CristianMSR/Oximetro/coso.jpeg

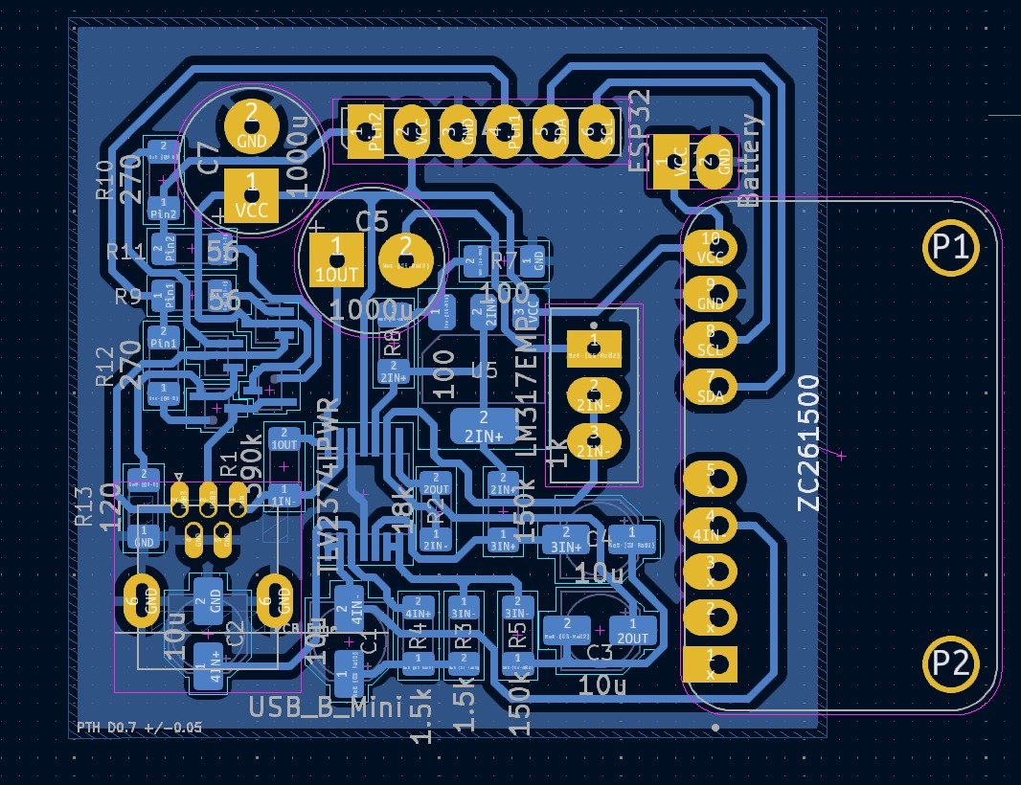
coso.jpeg
