CristianMSR/Oximetro/coso2.jpeg

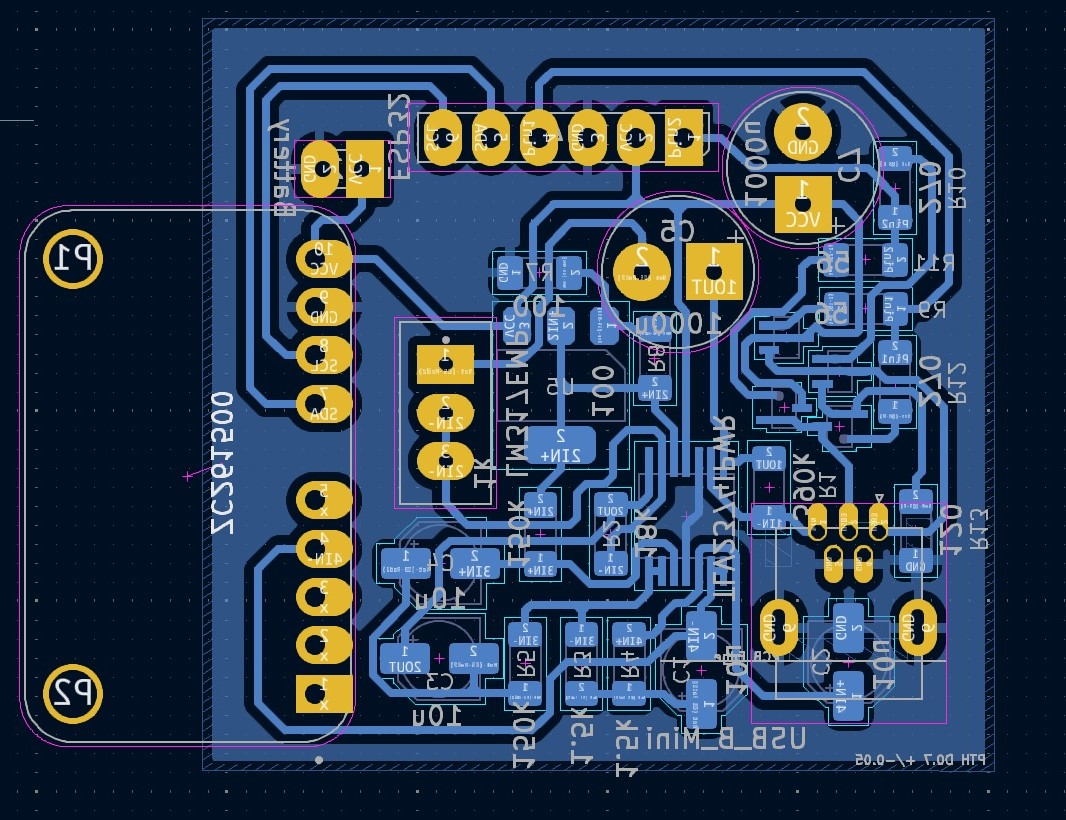
coso2.jpeg
