CristianMSR/Oximetro/capturas_osciloscopio/salidaAmplif.jpg

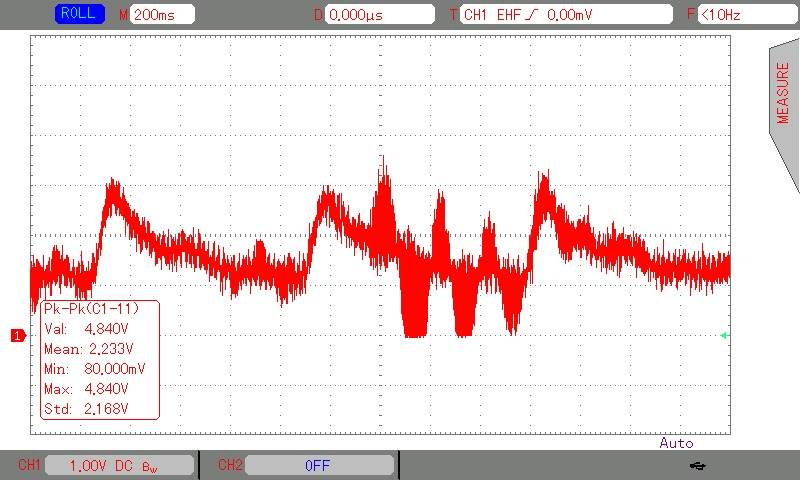
capturas_osciloscopio/salidaAmplif.jpg
