CristianMSR/Oximetro/capturas_osciloscopio/salidaFPA.jpg

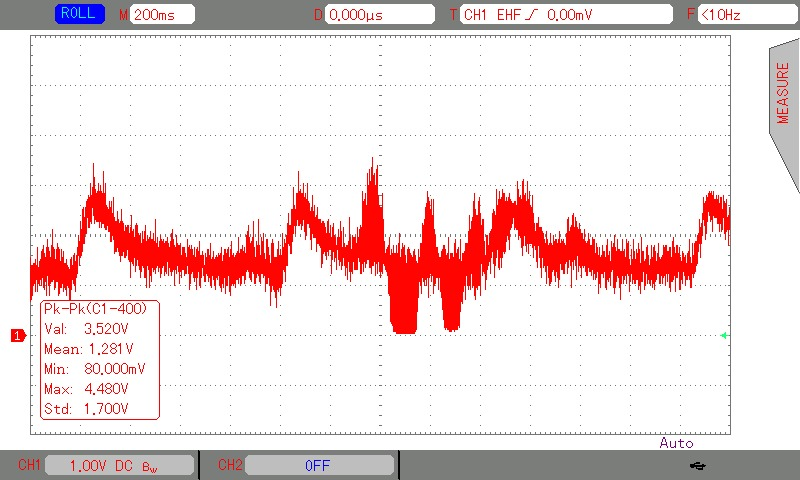
capturas_osciloscopio/salidaFPA.jpg
