CristianMSR/Oximetro/capturas_osciloscopio/salidaTransimp.jpg

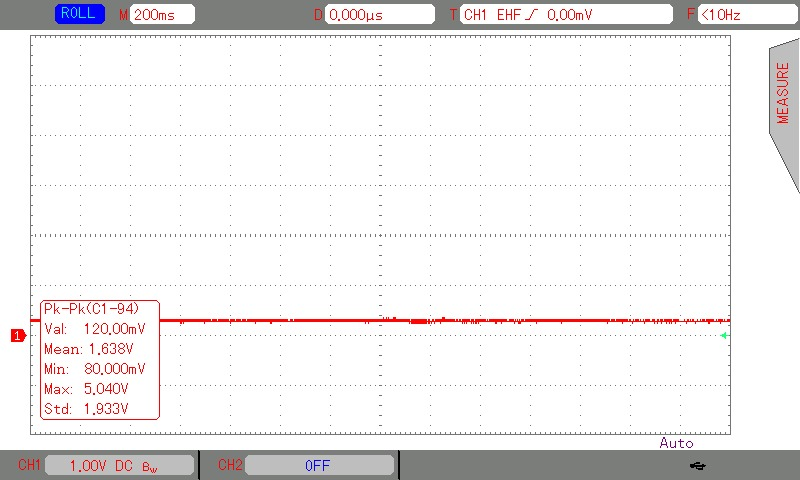
capturas_osciloscopio/salidaTransimp.jpg
