CristianMSR/Oximetro/capturas_osciloscopio/senalIR.jpg

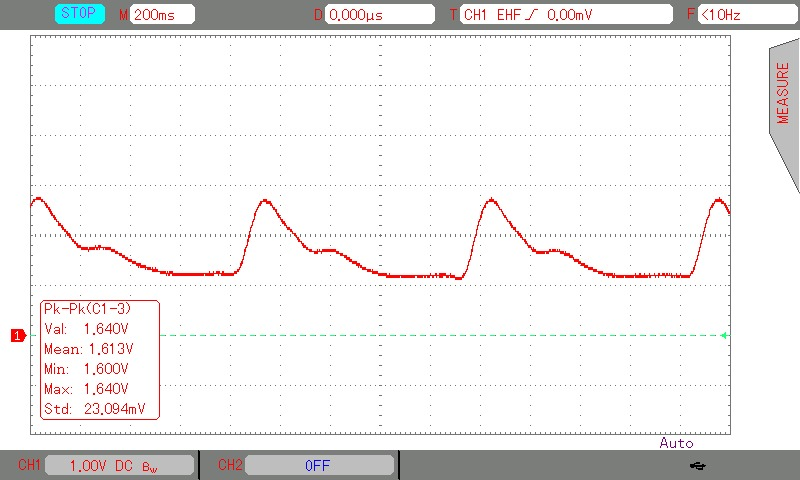
capturas_osciloscopio/senalIR.jpg
