CristianMSR/Oximetro/capturas_osciloscopio/senalRoja.jpg

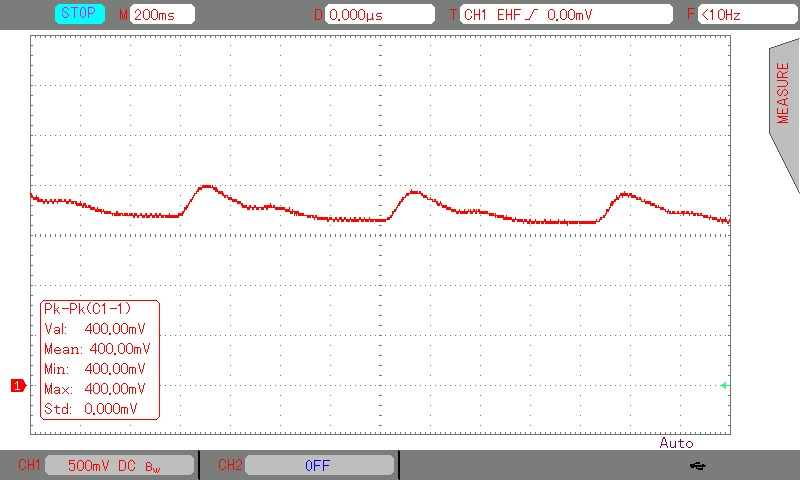
capturas_osciloscopio/senalRoja.jpg
