CristianMSR/Oximetro/Diagrama de bloques anteproyecto.png

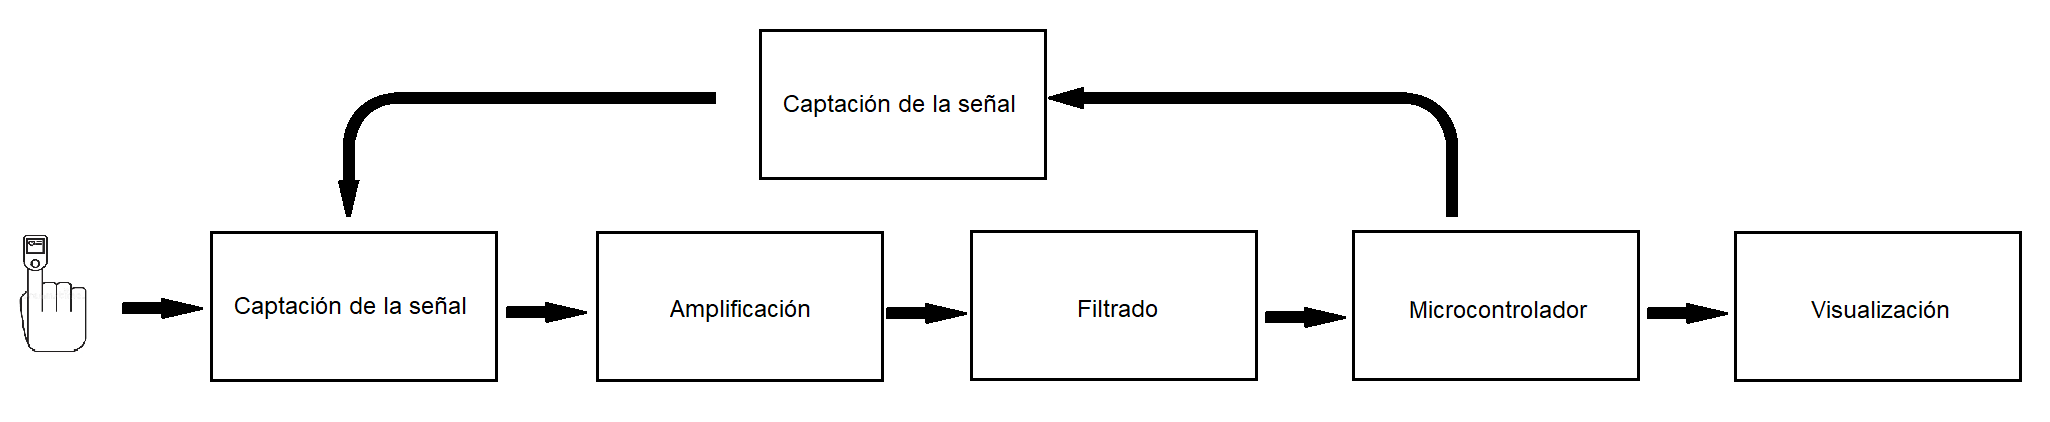
Diagrama de bloques anteproyecto.png
