CristianMSR/Oximetro/oximetro_final/app_escritorio/fondo.jpg

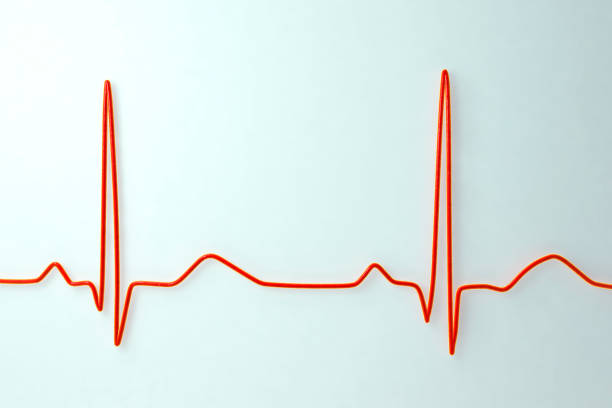
oximetro_final/app_escritorio/fondo.jpg
