CristianMSR/Oximetro/kicad/3DModels/BJT-NPN-SMD.step

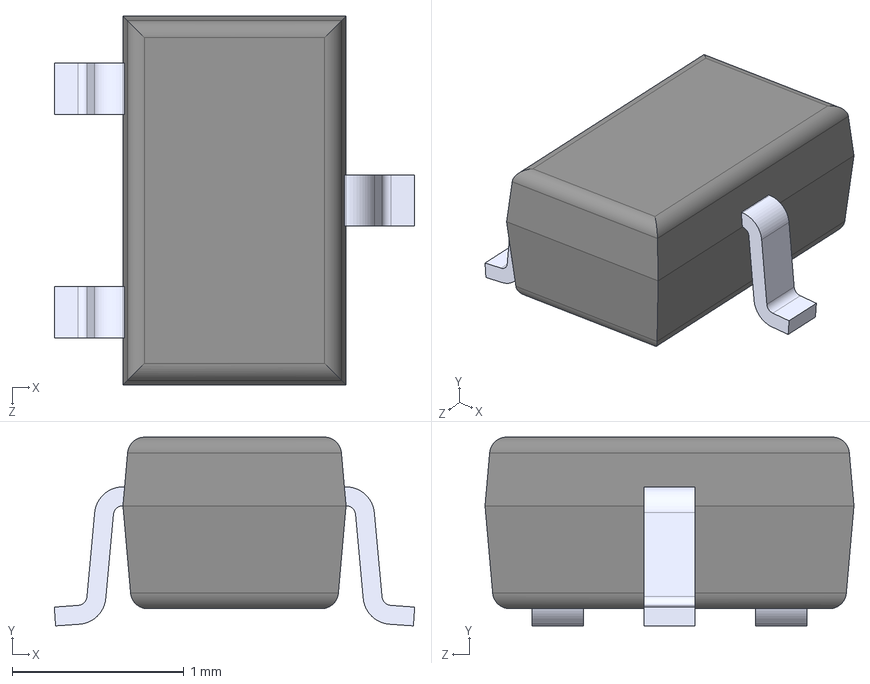
[picture p10: CAD file, 2024-11-26]
kicad/3DModels/BJT-NPN-SMD.step
2.10 x 1.10 x 2.15 mm
