CristianMSR/Oximetro/oximetro_final/3D-20.stl

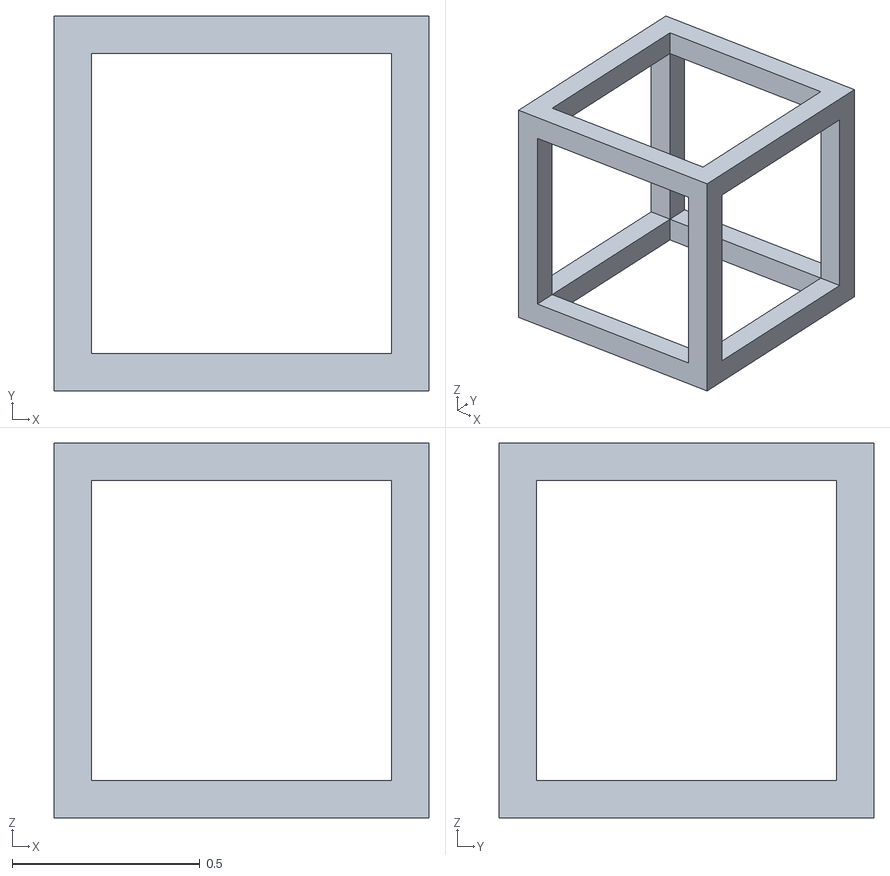
[picture p11: CAD file, 2024-11-29]
oximetro_final/3D-20.stl
1.00 x 1.00 x 1.00
