CristianMSR/Oximetro/kicad/3DModels/16Bit I2C ADC+PGA - ADS1115.stp

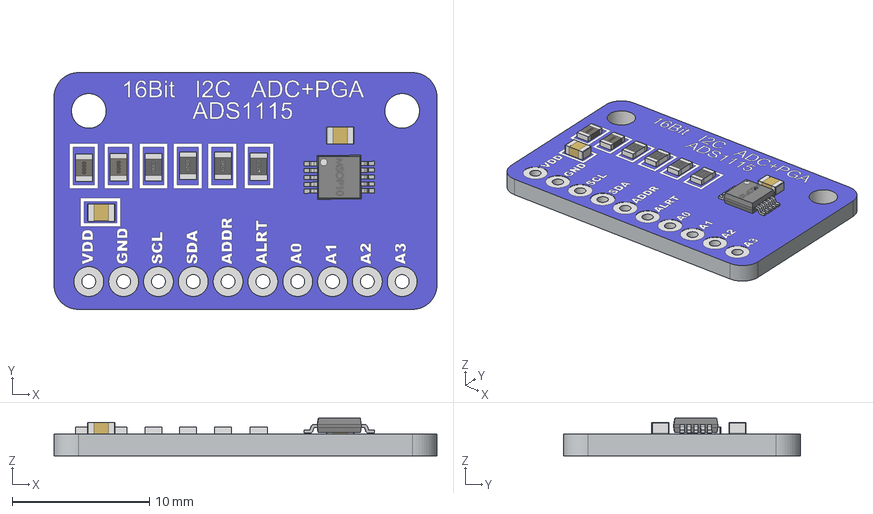
[picture p12: CAD file, 2024-11-26]
kicad/3DModels/16Bit I2C ADC+PGA - ADS1115.stp
27.9 x 17.3 x 2.74 mm
ADS1115
0805 Capacitor x 2
0805 Inductor x 2
0805 Resistor x 4
MSOP10
