CristianMSR/Oximetro/kicad/3DModels/multvueltas-3296W-1-103.step

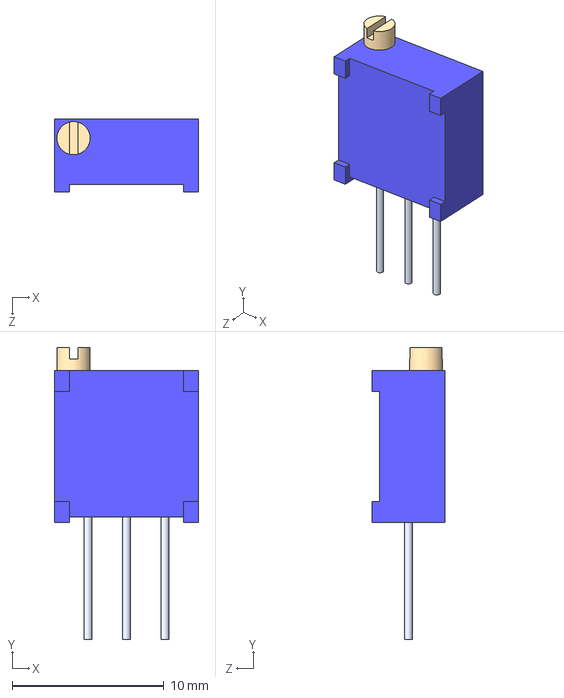
[picture p13: CAD file, 2024-11-26]
kicad/3DModels/multvueltas-3296W-1-103.step
9.53 x 19.3 x 4.83 mm
