CristianMSR/Oximetro/kicad/3DModels/opamp-TLV2374IPWR.step

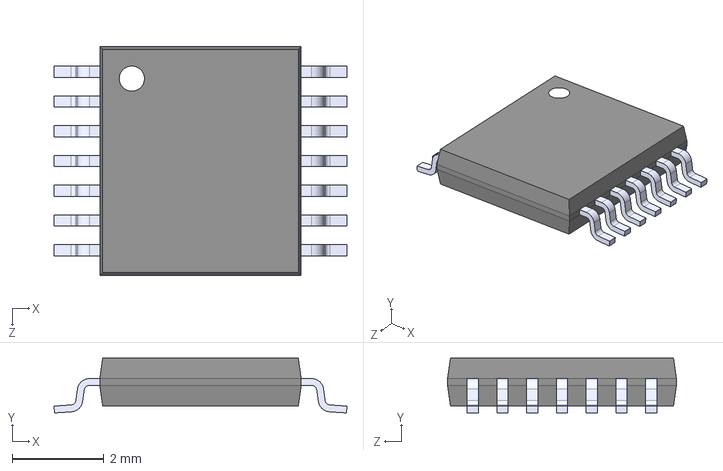
[picture p14: CAD file, 2024-11-26]
kicad/3DModels/opamp-TLV2374IPWR.step
6.40 x 1.20 x 5.00 mm
