CristianMSR/Oximetro/kicad/3DModels/miniUSB-typeB.stp

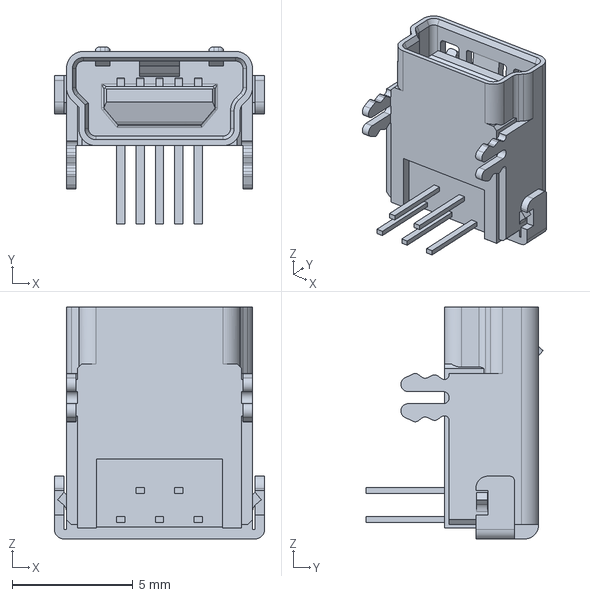
[picture p15: CAD file, 2024-11-26]
kicad/3DModels/miniUSB-typeB.stp
8.70 x 7.34 x 9.60 mm
