CristianMSR/Oximetro/output.pdf

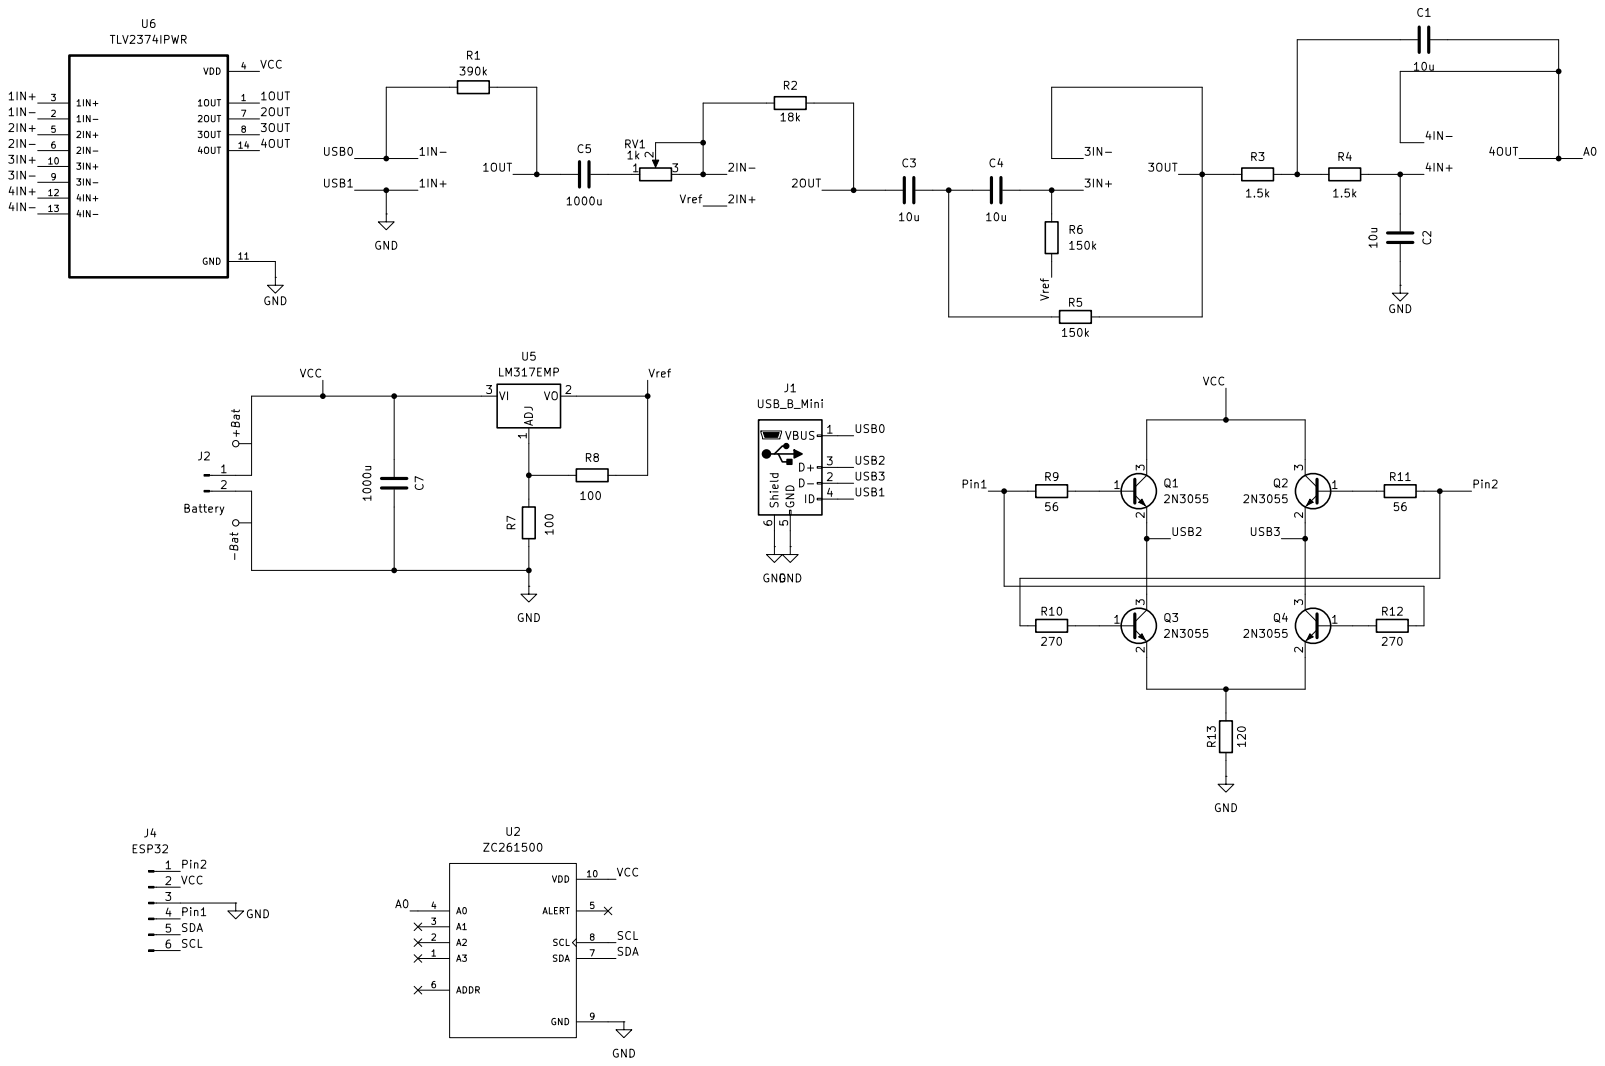
[picture p16: page 1]
