CristianMSR/Oximetro/capturas_osciloscopio/filtroPasabanda.pdf

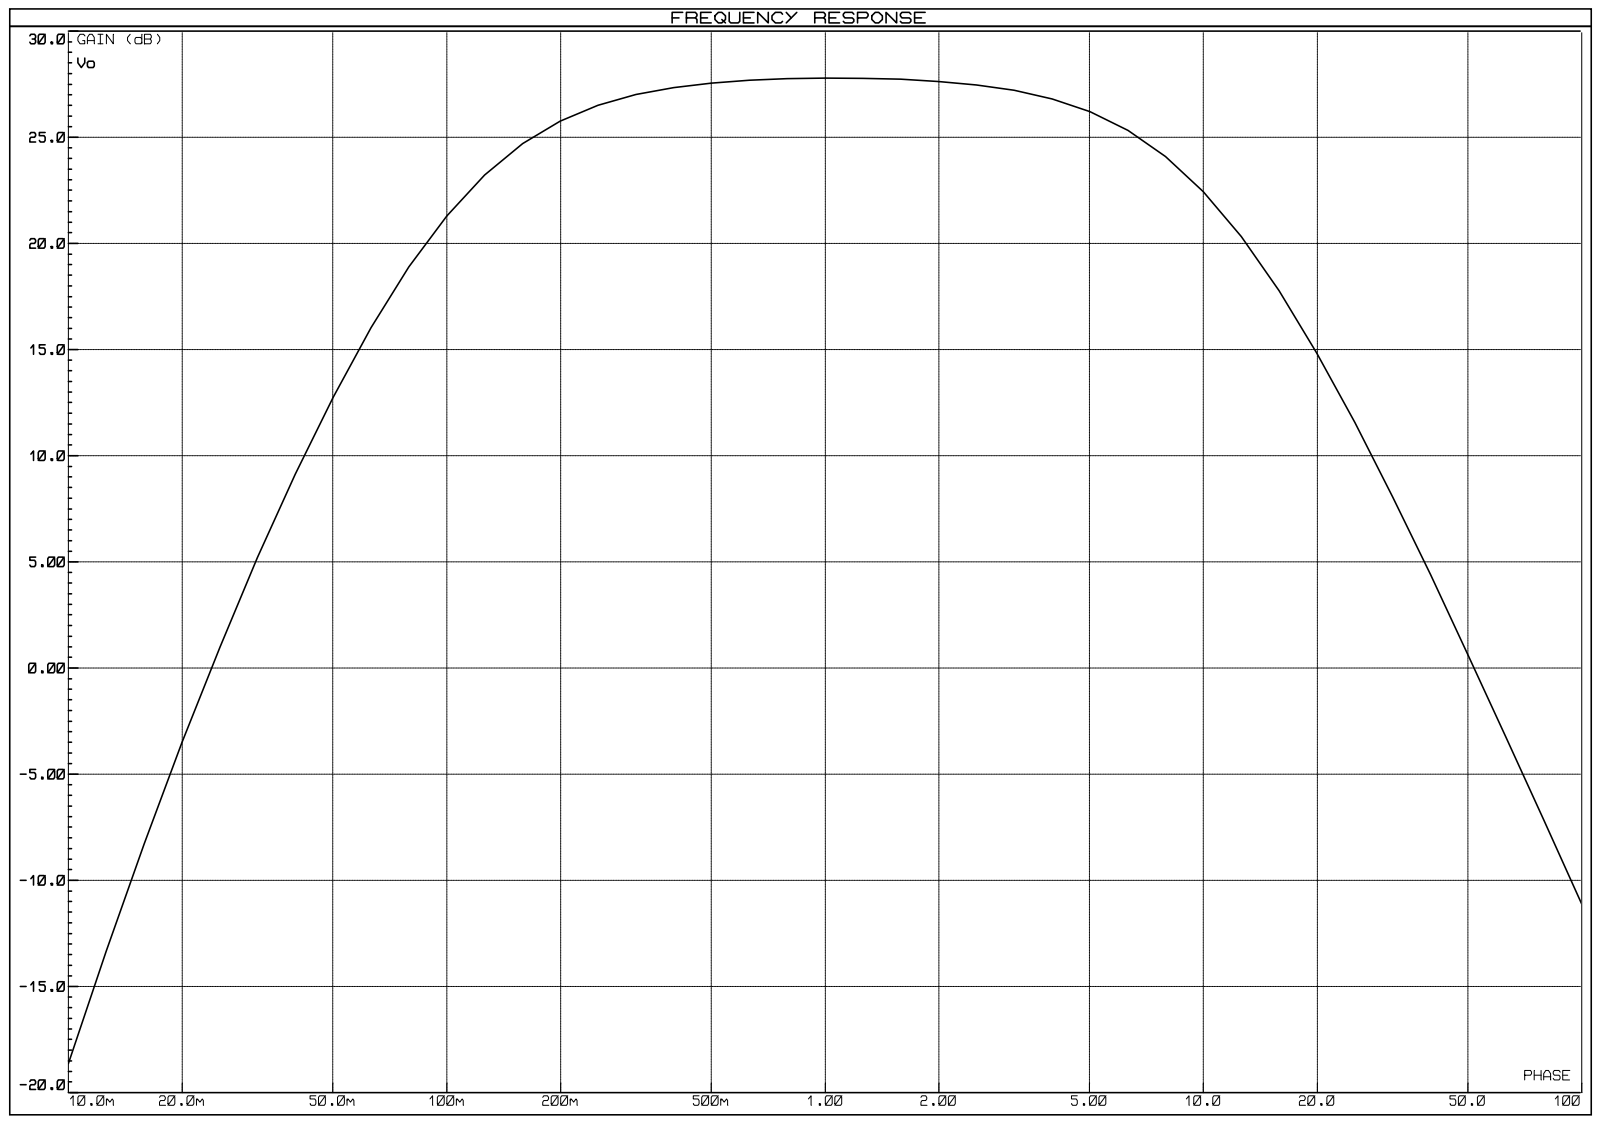
[picture p17: page 1]
