CristianMSR/Oximetro/kicad/planchado/imprimir_fuente.pdf

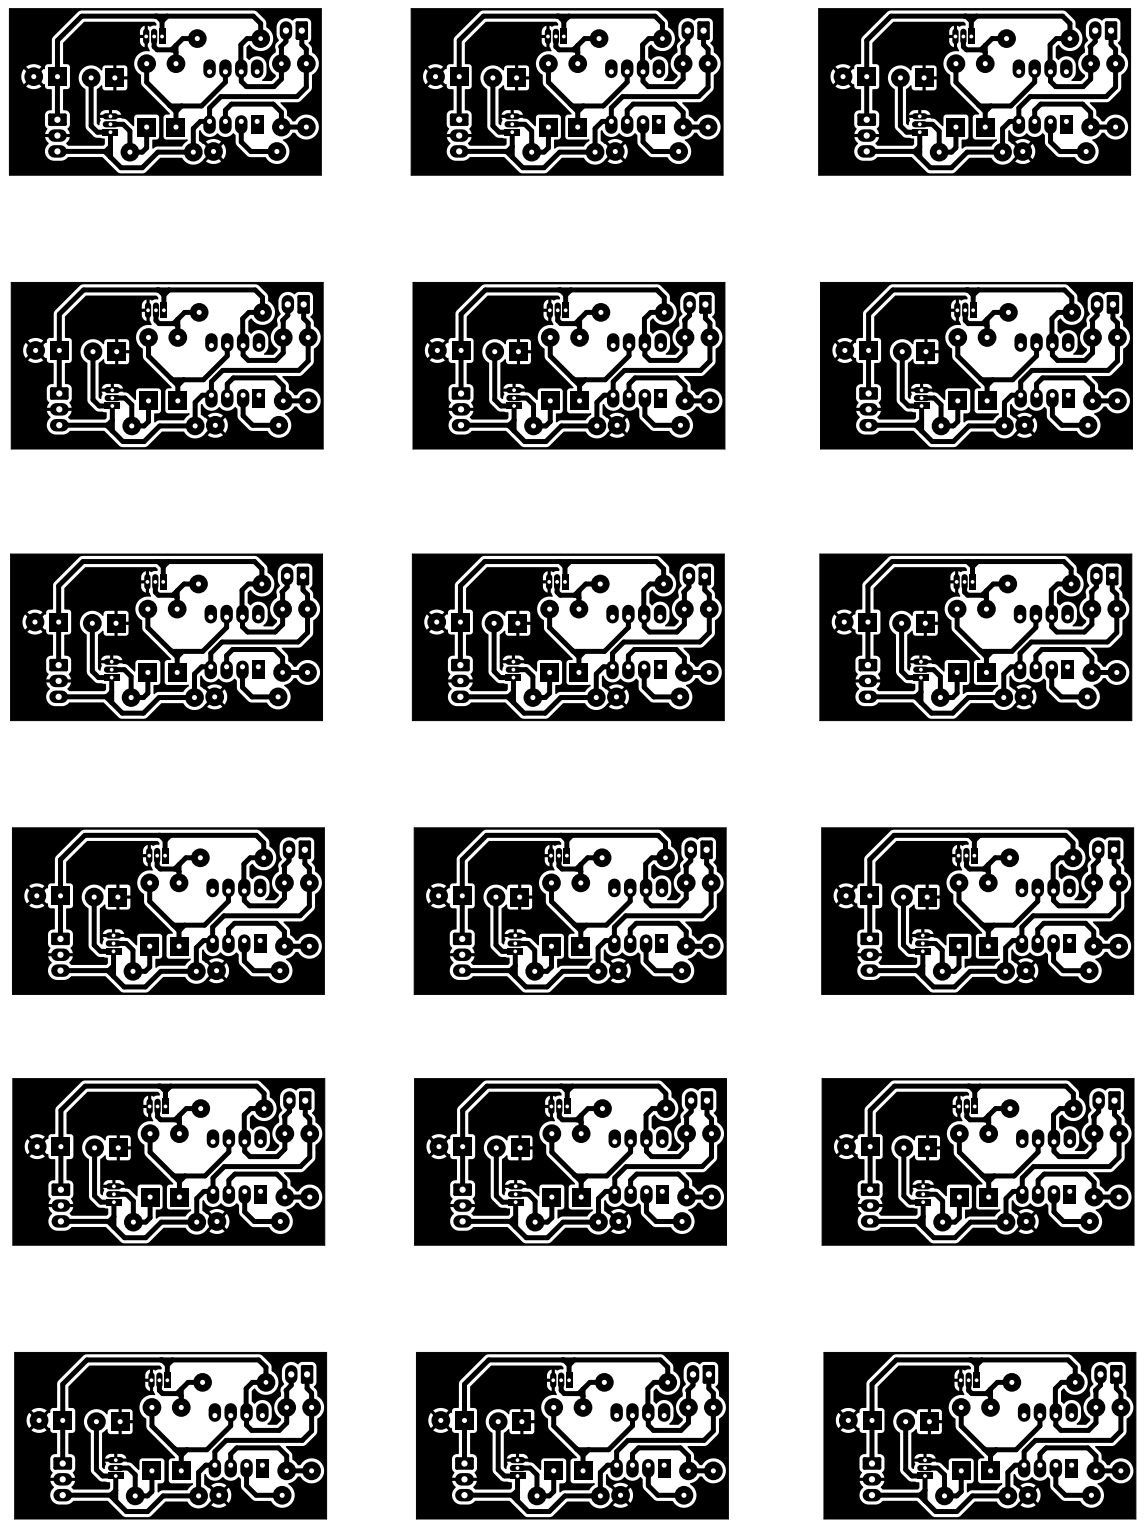
[picture p18: page 1]
