CristianMSR/Oximetro/kicad/planchado/imprimir_fuente_v2.pdf

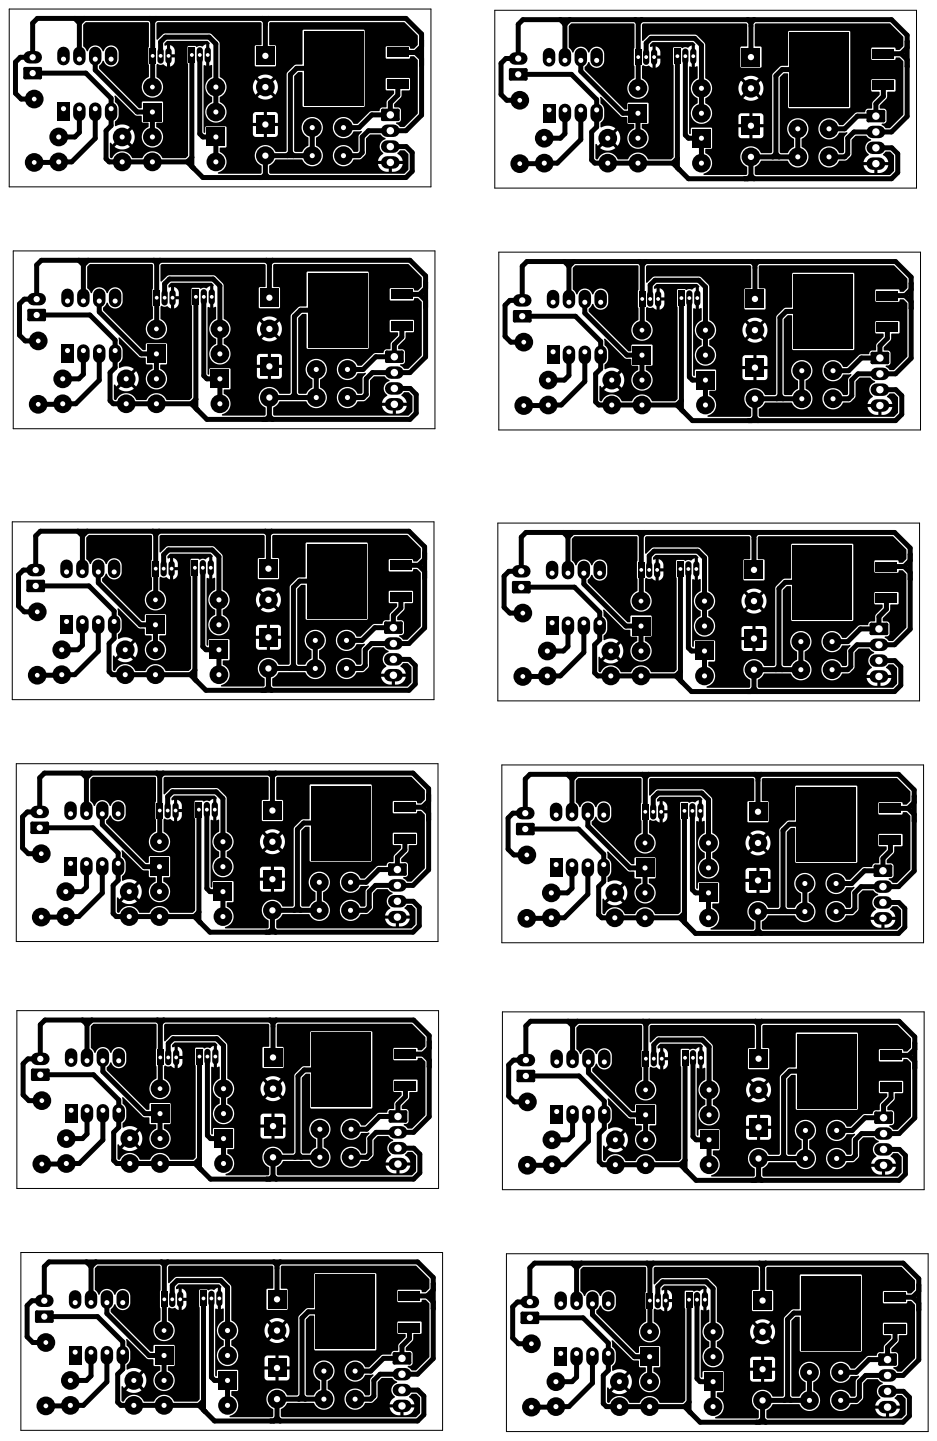
[picture p19: page 1]
