CristianMSR/Oximetro/kicad/planchado/oximeter.pdf

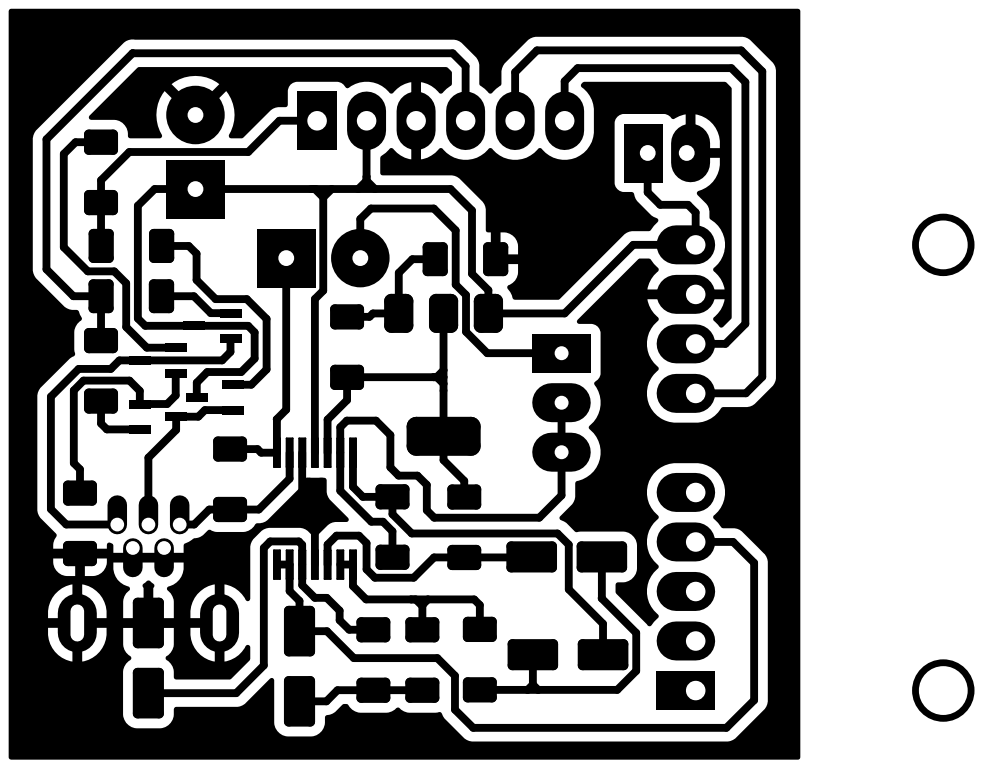
[picture p20: page 1]
