CristianMSR/Oximetro/kicad/planchado/planchado_oximeter.pdf

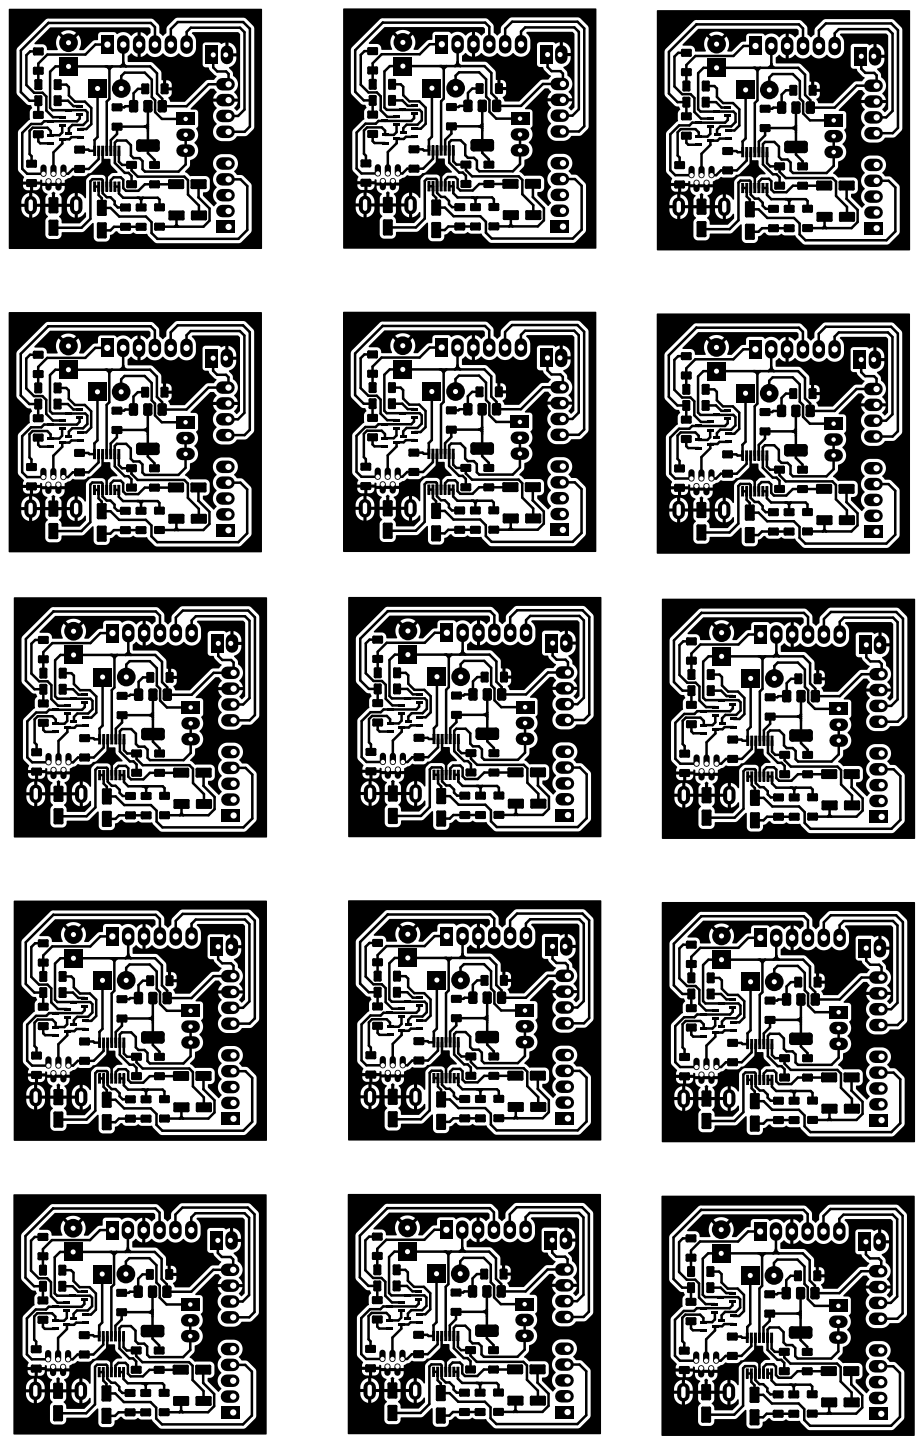
[picture p21: page 1]
