CristianMSR/Oximetro/kicad/proyectos/fuente/fuente.kicad_pcb

## KiCad design kicad/proyectos/fuente/fuente.kicad_pcb (2024-11-26)

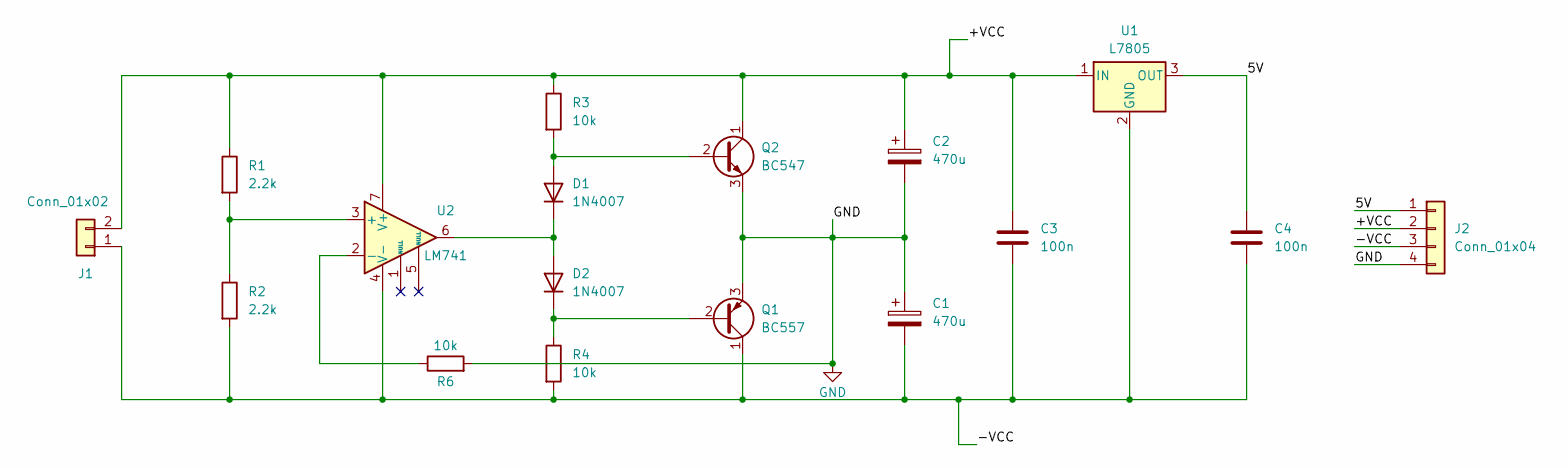
[picture p22: schematic fuente.kicad_sch]

Parts:
C1, C2: 470u; CP_Radial_D10.0mm_P5.00mm
C3, C4: 100n; C_Disc_D6.0mm_W2.5mm_P5.00mm
D1, D2: 1N4007; D_DO-41_SOD81_P10.16mm_Horizontal
J1: Conn_01x02; Molex_KK-254_AE-6410-02A_1x02_P2.54mm_Vertical
J2: Conn_01x04; Molex_KK-254_AE-6410-04A_1x04_P2.54mm_Vertical
Q1: BC557; TO-92_Inline
Q2: BC547; TO-92_Inline
R1, R2: 2.2k; R_Axial_DIN0207_L6.3mm_D2.5mm_P10.16mm_Horizontal
R3, R4, R6: 10k; R_Axial_DIN0207_L6.3mm_D2.5mm_P10.16mm_Horizontal
U1: L7805; L7805ACD2T
U2: LM741

Connections:
/5V: C4.1, J2.1, U1.3 (OUT)
/+VCC: C2.1, C3.1, J1.2, J2.2, Q2.1 (C), R1.1, R3.1, U1.1 (IN), U2.7 (V+)
/-VCC: C1.2, C3.2, C4.2, J1.1, J2.3, Q1.1 (C), R2.2, R4.2, U1.2 (GND), U2.4 (V-)
GND: C1.1, C2.2, J2.4, Q1.3 (E), Q2.3 (E), R6.2
unnamed: D1.2 (A), Q2.2 (B), R3.2
unnamed: D1.1 (K), D2.2 (A), U2.6
unnamed: D2.1 (K), Q1.2 (B), R4.1
unnamed: R1.2, R2.1, U2.3 (+)
unnamed: R6.1, U2.2 (-)

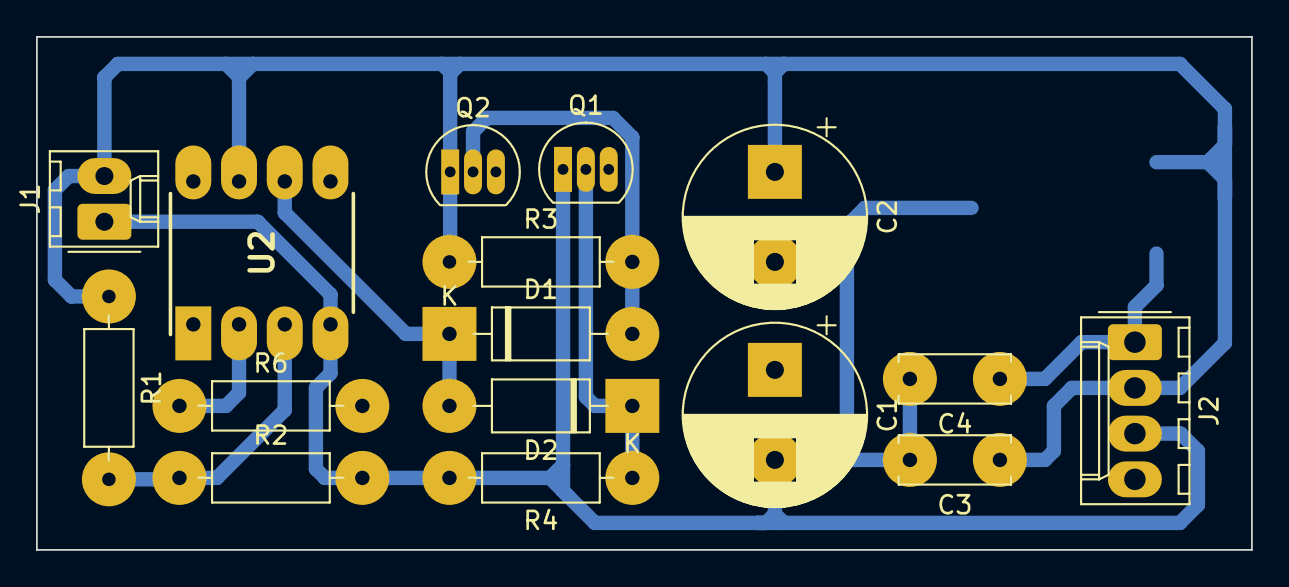
[picture p23: board fuente.kicad_pcb from above]

Board: 2 copper layers, 67.5 x 28.5 mm, 17 parts (1 on the bottom side), 9 nets.
