CristianMSR/Oximetro/kicad/proyectos/oximeter/oximeter.kicad_pcb

## KiCad design kicad/proyectos/oximeter/oximeter.kicad_pcb (2024-11-26)

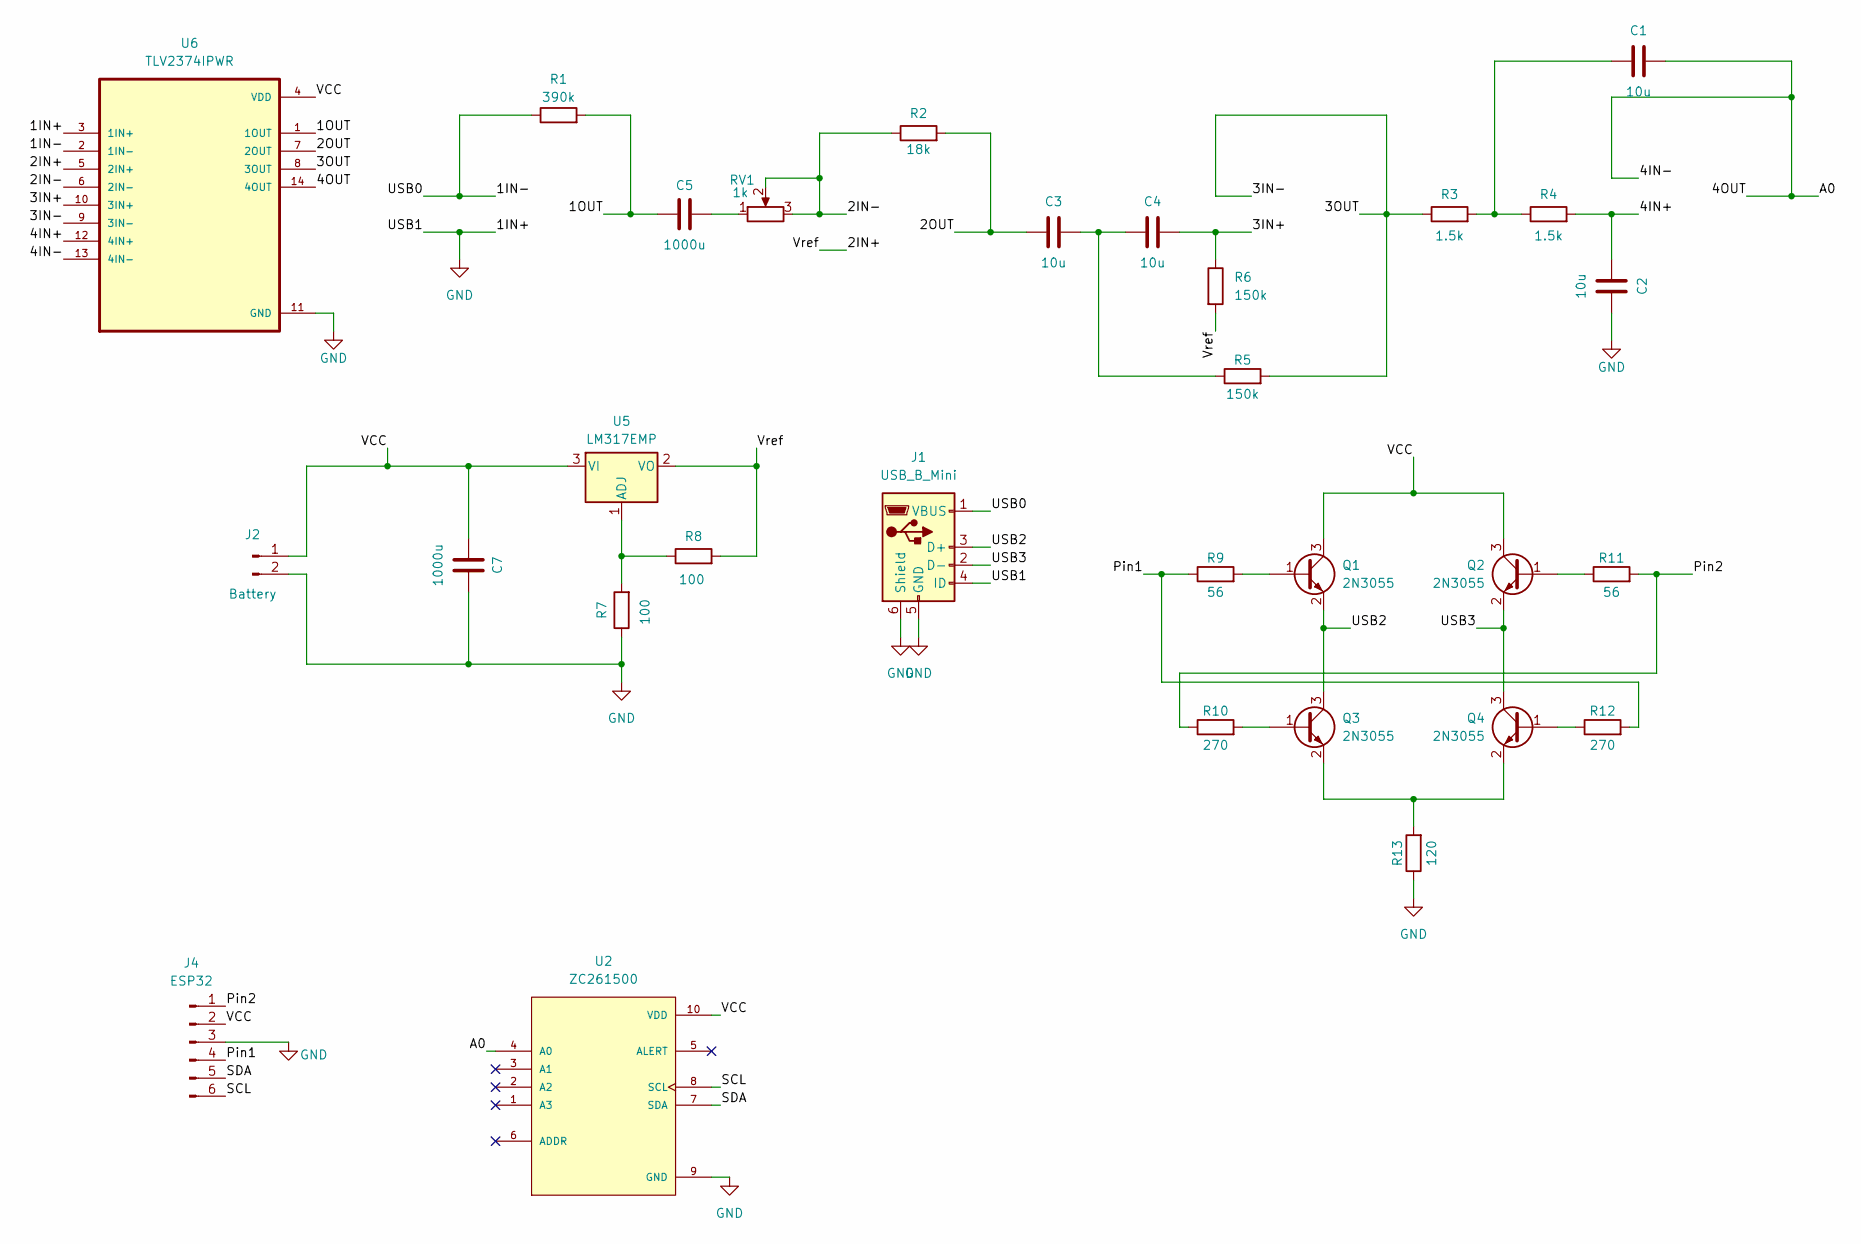
[picture p24: schematic oximeter.kicad_sch]

Parts:
C1, C2, C3, C4: 10u; CP_Elec_4x3
C5, C7: 1000u; CP_Radial_D8.0mm_P3.80mm
J1: USB_B_Mini; miniUSB-B-20
J2: Battery; PinHeader_1x02_P2.00mm_Vertical
J4: ESP32; PinHeader_1x06_P2.54mm_Vertical
Q1, Q2, Q3, Q4: 2N3055; BJT-NPN-SMD
R1: 390k; R_1206_3216Metric_Pad1.30x1.75mm_HandSolder
R2: 18k; R_1206_3216Metric_Pad1.30x1.75mm_HandSolder
R3, R4: 1.5k; R_1206_3216Metric_Pad1.30x1.75mm_HandSolder
R5, R6: 150k; R_1206_3216Metric_Pad1.30x1.75mm_HandSolder
R7, R8: 100; R_1206_3216Metric_Pad1.30x1.75mm_HandSolder
R9, R11: 56; R_1206_3216Metric_Pad1.30x1.75mm_HandSolder
R10, R12: 270; R_1206_3216Metric_Pad1.30x1.75mm_HandSolder
R13: 120; R_1206_3216Metric_Pad1.30x1.75mm_HandSolder
RV1: 1k; TRIM_3296W-1-103
U2: ZC261500; MODULE_ZC261500; PARTREV NA
U5: LM317EMP; SOT-223-3_TabPin2
U6: TLV2374IPWR; opamp-TLV2374IPWR

Connections:
/1IN-: J1.1 (VBUS), R1.1, U6.2 (1IN-)
/1OUT: C5.1, R1.2, U6.1 (1OUT)
/2IN+: R6.2, R8.2, U5.2 (VO), U6.5 (2IN+)
/2IN-: R2.1, RV1.2, RV1.3, U6.6 (2IN-)
/2OUT: C3.1, R2.2, U6.7 (2OUT)
/3IN+: C4.2, R6.1, U6.10 (3IN+)
/3IN-: R3.1, R5.2, U6.8 (3OUT), U6.9 (3IN-)
/4IN+: C2.1, R4.2, U6.12 (4IN+)
/4IN-: C1.2, U2.4 (A0), U6.13 (4IN-), U6.14 (4OUT)
/Pin1: J4.4, R9.1, R12.2
/Pin2: J4.1, R10.1, R11.2
/SCL: J4.6, U2.8 (SCL)
/SDA: J4.5, U2.7 (SDA)
/USB2: J1.3 (D+), Q1.2 (E), Q3.3 (C)
/USB3: J1.2 (D-), Q2.2 (E), Q4.3 (C)
/VCC: C7.1, J2.1, J4.2, Q1.3 (C), Q2.3 (C), U2.10 (VDD), U5.3 (VI), U6.4 (VDD)
GND: C2.2, C7.2, J1.4 (ID), J1.5 (GND), J1.6 (Shield), J2.2, J4.3, R7.1, R13.1, U2.9 (GND), U6.3 (1IN+), U6.11 (GND)
unnamed: C1.1, R3.2, R4.1
unnamed: C3.2, C4.1, R5.1
unnamed: C5.2, RV1.1
unnamed: Q1.1 (B), R9.2
unnamed: Q2.1 (B), R11.1
unnamed: Q3.1 (B), R10.2
unnamed: Q3.2 (E), Q4.2 (E), R13.2
unnamed: Q4.1 (B), R12.1
unnamed: R7.2, R8.1, U5.1 (ADJ)

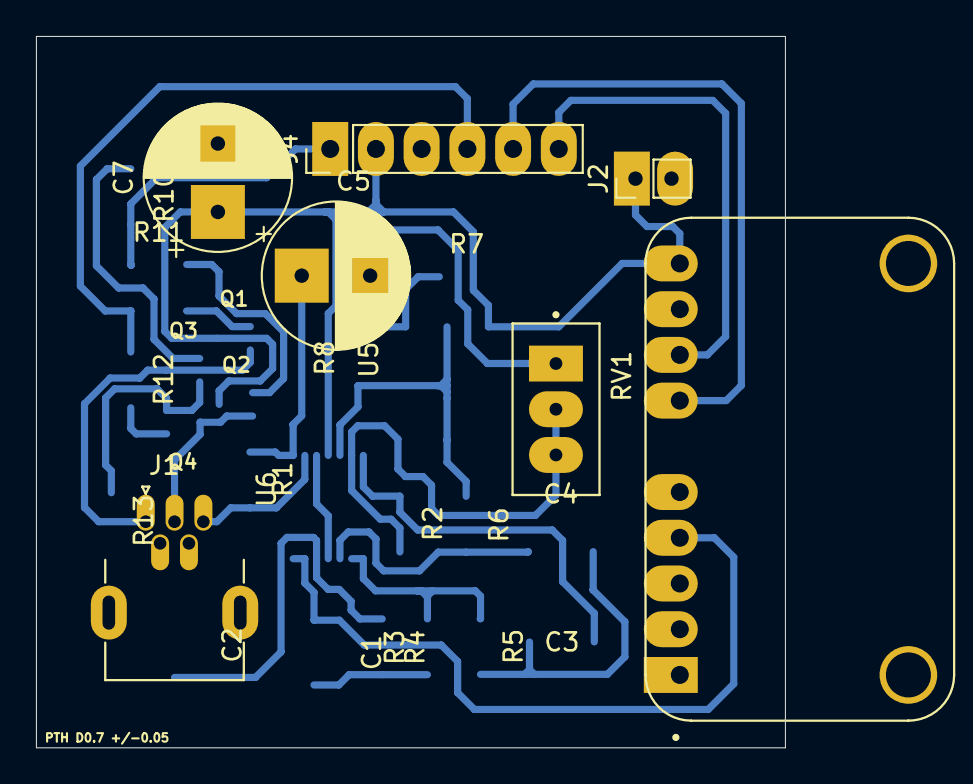
[picture p25: board oximeter.kicad_pcb from above]

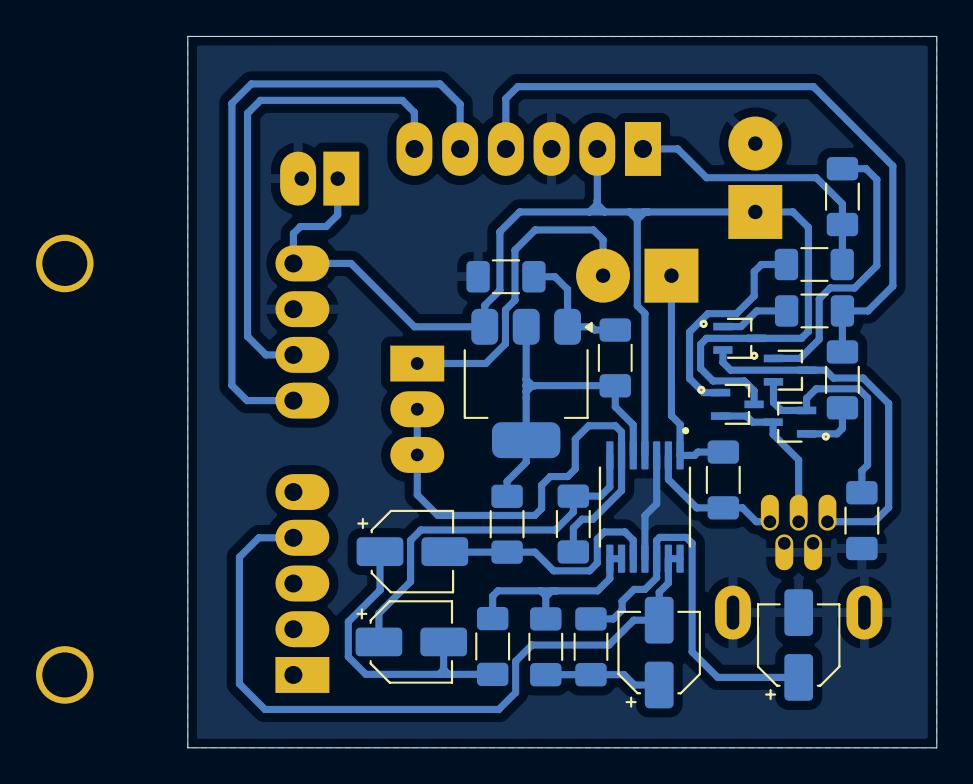
[picture p26: board oximeter.kicad_pcb from below]

Board: 2 copper layers, 41.6 x 39.5 mm, 30 parts (23 on the bottom side), 26 nets.
