CristianMSR/Oximetro/(commit log)

2024-10-25 Subo el proyecto completo, después ordenamos
2024-10-31 Add kicad files
    [16Bit I2C ADC+PGA - ADS1115.stp, BJT-NPN-SMD.step, fuente.kicad_pcb, fuente.kicad_sch, miniUSB-typeB.stp, multvueltas-3296W-1-103.step, opamp-TLV2374IPWR.step, oximeter.kicad_pcb]
